M5Ross/AccDec_8Coil/pcb/BOM_PCB_AccDec8Coil.csv

ID | Name | Designator | Footprint | Quantity | Manufacturer Part | Manufacturer | Supplier | Supplier Part | Price
1 | WJ126V-5.0-2P | P11,P1 | WJ126V-5.0-2P | 2
2 | Header-Female-2.54_1x4 | P10 | HDR-4X1/2.54 | 1
3 | ULN2803G-D18-T | U6,U3,U1,U2 | DIP-18 | 4
4 | GBP410(84MIL) | D1 | GBP-14.0X3.2 | 1
5 | ATMEGA328P-PU | U5 | DIP-28_300MIL | 1
6 | 10k | R4,R1 | AXIAL-0.3 | 2
7 | 1k | R3,R2 | AXIAL-0.3 | 2
8 | 1N4148 | D2 | DO-35 | 1
9 | 78L05ML-T92-B | U7 | TO-92(TO-92-3) | 1
10 | 1000uF | C5,C6 | CAP-D12.5XF5.0 | 2
11 | WJ126V-5.0-3P | P4,P5,P6,P7,P8,P9,P2,P3 | WJ126V-5.0-3P | 8
12 | 6N136 | U4 | DIP-8 | 1
13 | 22pF | C2,C1 | CAP-TH_L3.5-W3.0-P2.54-D0.8 | 2
14 | LED-3MM | LED1 | LED-3MM/2.54 | 1
15 | 100nF(104) | C4 | CAP-CT4G-0805-2.54MM | 1
16 | 16MHz | X1 | HC-49S | 1
17 | 10uF | C3,C7 | CAP-D5.0XF2.0 | 2
