M5Ross/AccDec_8Coil/sch/Schematic_AccDec8Coil.pdf

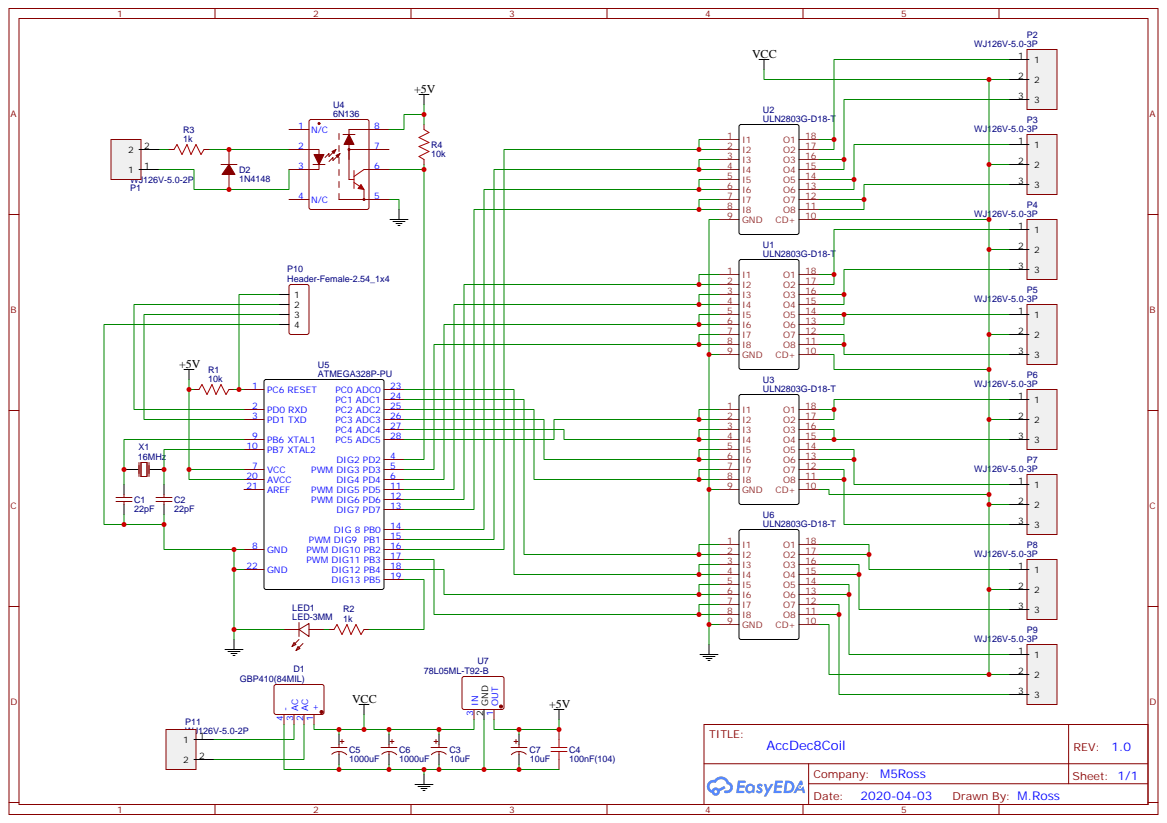
[picture p1: page 1]
