M5Ross/AccDec_8Coil/(commit log)

2022-12-04 Add schematic
2022-12-04 Add pcb, bom and gerber files
    [BOM_PCB_AccDec8Coil.csv]
2024-06-14 Add possibility to skip pre-positioning at power-on
    [AccDec_8Coil.ino]
